nshutifidele23-cmd/BE-Ruche-avec-STM32-G15/BE RUCHE/LORA/Trammes/Signal Lora.jpeg

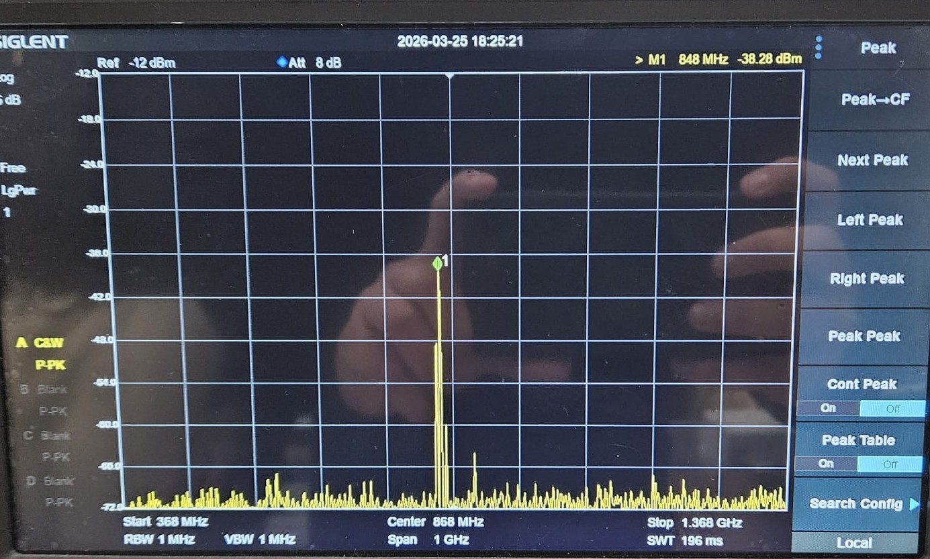
BE RUCHE/LORA/Trammes/Signal Lora.jpeg
