nshutifidele23-cmd/BE-Ruche-avec-STM32-G15/TP CAPTEURS/Compte_Rendu_TP_Partie_Capteur_STM32_2026_G15.pdf

Département EEA - Faculté Sciences et Ingénierie

## M1 EEA Parcours Systemes et Microsystemes Embarques

## Compte Rendu du BE partie capteurs

Année 2025–2026

Rédigé par ARIEF Audy et NSHUTI NKURIKIYINKA Fidèle

4 avril 2026

Université de Toulouse | Master Systèmes et Microsystèmes Embarqués

Table des matières

1 Introduction | 2
2 Capteur SHT31 | 2
3 Capteur DHT11 | 2
4 Affichage LCD : lcd_affichage | 4
5 Conclusion | 4

### 1 Introduction

Ce TP constitue la première étape du projet de ruche connectée. L’objectif de cette partie est de prendre en main deux capteurs de température et d’humidité (SHT31 et le DHT11) sur la carte STM32L476RG (Nucleo-L476RG), de comprendre leurs protocoles de communication respectifs, et d’afficher les mesures sur un écran LCD RGB I2C.
Les deux capteurs mesurent les mêmes grandeurs physiques (température et humidité relative) mais avec des interfaces très différentes : le SHT31 communique via le bus I2C, tandis que le DHT11 utilise un protocole propriétaire mono fil à base de durées d’impulsions. Ce TP permet de comparer deux approches d’interfaçage courantes.

### 2 Capteur SHT31

### 2.1 Présentation du capteur

Le SHT31 est un capteur numérique de température et d’humidité relative fabriqué par Sensirion. Il offre une précision de ± 0,3 °C en température et ± 2 % en humidité relative. La communication s’effectue via le bus I2C, avec une adresse configurable par la broche ADDR (0x44 ou 0x45).

### 2.2 Protocole de communication I2C

Le SHT31 fonctionne par envoi de commandes sur 2 octets. L’hôte envoie une commande de mesure, attend la fin de la conversion, puis lit 6 octets en retour : 2 octets de température, 1 octet de CRC, 2 octets d’humidité, 1 octet de CRC.

### 2.3 Implémentation : sht_init

Notre implémentation se concentre sur la fonction d’initialisation sht_init, qui envoie la commande de déclenchement d’une mesure en mode répétabilité haute (0x2C, 0x10) via HAL_I2C_Master_Transmit sur l’adresse SHT_ADDRESS_A. Un délai de 5 ms est ensuite respecté pour laisser le temps au capteur de compléter la conversion avant toute lecture. Cette commande est appelée en boucle dans le main, avec un délai de 1 s entre chaque déclenchement.

### 2.4 Résultat

À ce stade du TP, l’initialisation et le déclenchement de mesure ont été validés. La commande est transmise correctement sur le bus I2C et le capteur répond sans erreur. La lecture et le décodage des 6 octets de réponse constituent la prochaine étape d’intégration.

### 3 Capteur DHT11

### 3.1 Présentation du capteur

Le DHT11 est un capteur bas coût de température et d’humidité relative. Sa précision est limitée (± 2 °C, ± 5 % HR) mais il est largement utilisé pour des applications de prototypage. Il communique via un protocole propriétaire mono-fil : une seule broche GPIO assure à la fois l’envoi de la commande de déclenchement et la réception des données, en codant les bits par la durée des états haut et bas.

### 3.2 Gestion du temps en microsecondes

Le protocole DHT11 requiert des délais précis à l’échelle de la microseconde, que HAL_Delay ne peut pas fournir (résolution 1 ms). Nous avons donc implémenté une fonction delay basée sur le timer TIM1, configuré avec un prescaler de 79 pour obtenir un comptage à 1 µs sur une horloge système de 80 MHz. La fonction réinitialise le compteur puis attend activement qu’il atteigne la valeur cible.

### 3.3 Initialisation : DHT11_Init

La séquence d’initialisation, conforme à la datasheet du DHT11, se déroule comme suit :

1. La broche GPIO est configurée en sortie et tirée à l’état bas pendant au moins 18 ms pour déclencher le capteur.
2. Elle est remontée à l’état haut pendant 10 µs, puis repassée en entrée avec résistance de tirage interne.
3. Après 40 µs d’attente, la fonction vérifie la réponse du DHT11 : celui-ci doit tirer la ligne à bas pendant ∼80 µs, puis la remettre à haut pendant ∼80 µs pour confirmer sa présence.
4. Un timeout de 2 ms (basé sur HAL_GetTick) est utilisé pour éviter un blocage infini si le capteur ne répond pas.

La fonction retourne 1 si le capteur a correctement répondu, 0 sinon.

### 3.4 Lecture des données : DHT11_Read

La fonction DHT11_Read lit un octet (8 bits) depuis le DHT11. Pour chaque bit, la logique est la suivante : le DHT11 signale le début d’un bit par une impulsion basse de ∼50 µs, puis encode le bit par la durée de l’état haut (∼26 µs pour un 0, ∼70 µs pour un 1). La fonction attend la fin de l’impulsion basse, puis échantillonne l’état de la ligne après 40 µs : si la ligne est encore haute, le bit vaut 1 ; si elle est déjà retombée, le bit vaut
0. Les bits sont accumulés du poids fort au poids faible dans un octet retourné en fin de fonction.
Cette fonction est appelée 5 fois consécutivement dans le main : 2 octets d’humidité (MSB, LSB), 2 octets de température (MSB, LSB), et 1 octet de checksum.

### 3.5 Vérification et décodage dans le main

Après les 5 lectures, le main calcule la somme des 4 premiers octets et la compare au checksum reçu. Si la vérification réussit, les valeurs sont décodées :
— Température : si le MSB de TC1 est à 1 (bit 7), la température est négative et
calculée depuis TC2 ; sinon, les deux octets sont combinés par (TC1 « 8) | TC2
et divisés par 10 pour obtenir la valeur en °C. Le résultat est multiplié par 100 pour stocker deux décimales dans un entier.
— Humidité : même principe, combinaison de RH1 et RH2, divisée par 10, multipliée par 100.

### 4 Affichage LCD : lcd_affichage

La fonction lcd_affichage efface l’écran et affiche sur deux lignes :
— Ligne 0 : Temp : XX.XX °C (le symbole degré est produit par le code caractère 0xDF du LCD) ;
— Ligne 1 : Humi : XX.XX %.
Le formatage utilise la même technique que pour le poids dans le BE Ruche : la division entière par 100 donne la partie entière, le modulo 100 donne les deux chiffres décimaux, évitant ainsi l’utilisation des flottants dans sprintf. Le rétroéclairage est maintenu en blanc.

### 5 Conclusion

Ce TP a permis de comparer deux approches très différentes d’interfaçage de capteurs environnementaux sur STM32. Le SHT31, piloté via I2C avec les fonctions HAL standard, s’est révélé simple à intégrer et offre une bonne précision. Le DHT11, avec son protocole mono fil et ses contraintes temporelles à la microseconde, a nécessité une implémentation plus manuelle, notamment pour la gestion du timer et le décodage bit à bit.
