nshutifidele23-cmd/BE-Ruche-avec-STM32-G15/BE RUCHE/LCD_HX711_STM32/Trammes/trame_Communication_HX711.PNG

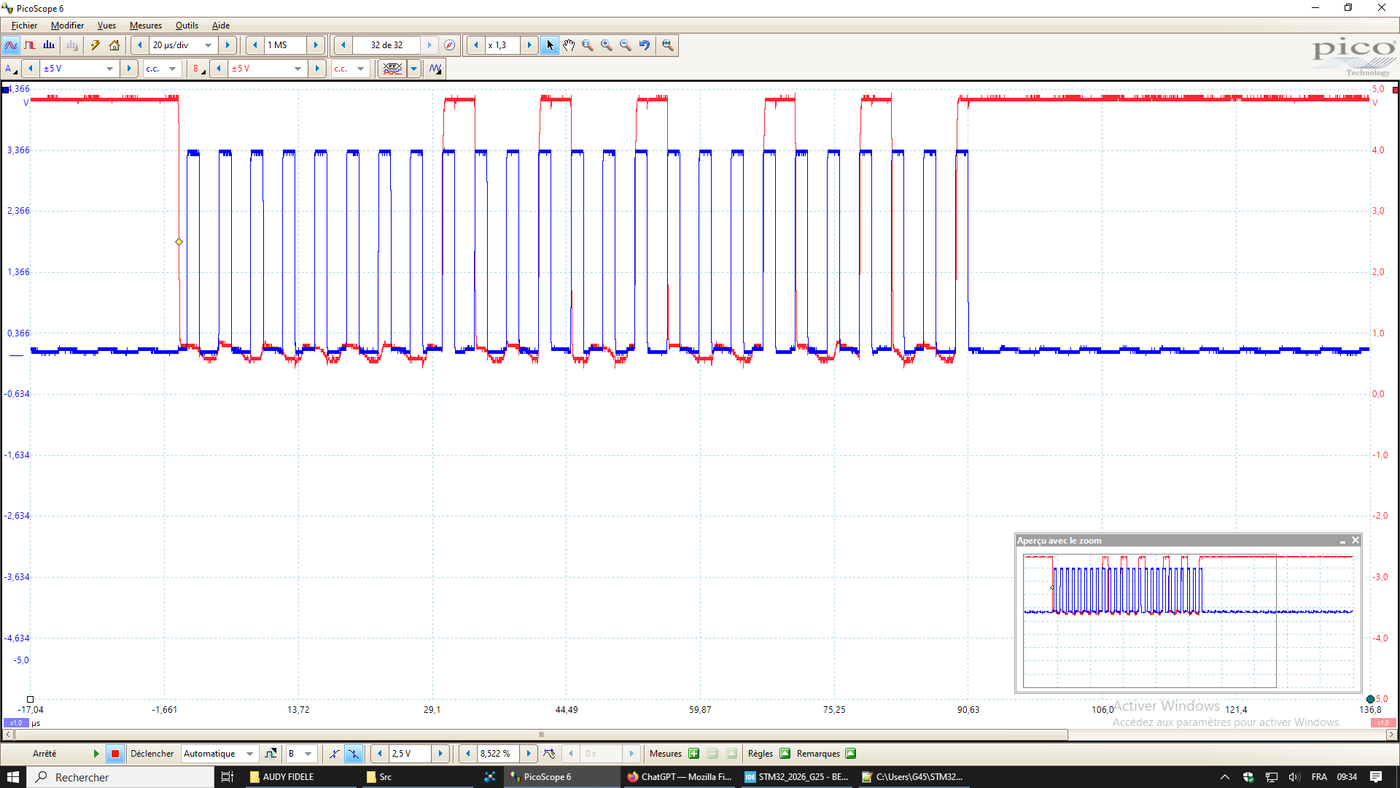
BE RUCHE/LCD_HX711_STM32/Trammes/trame_Communication_HX711.PNG
