nshutifidele23-cmd/BE-Ruche-avec-STM32-G15/BE RUCHE/LCD_HX711_STM32/Trammes/Tramme_Message_1s_HX711.PNG

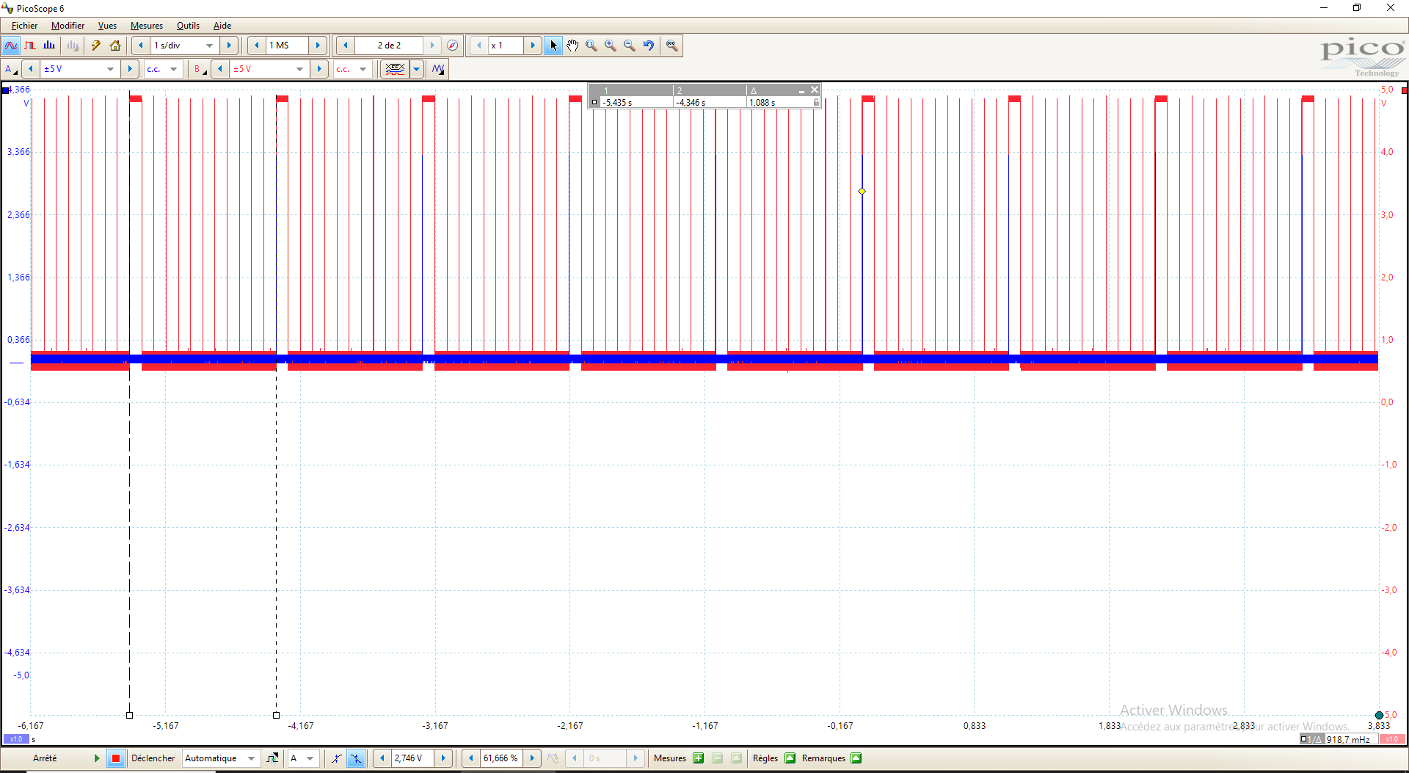
BE RUCHE/LCD_HX711_STM32/Trammes/Tramme_Message_1s_HX711.PNG
