nshutifidele23-cmd/BE-Ruche-avec-STM32-G15/TP CAPTEURS/DHT11/Docs/dht11 tramme.PNG

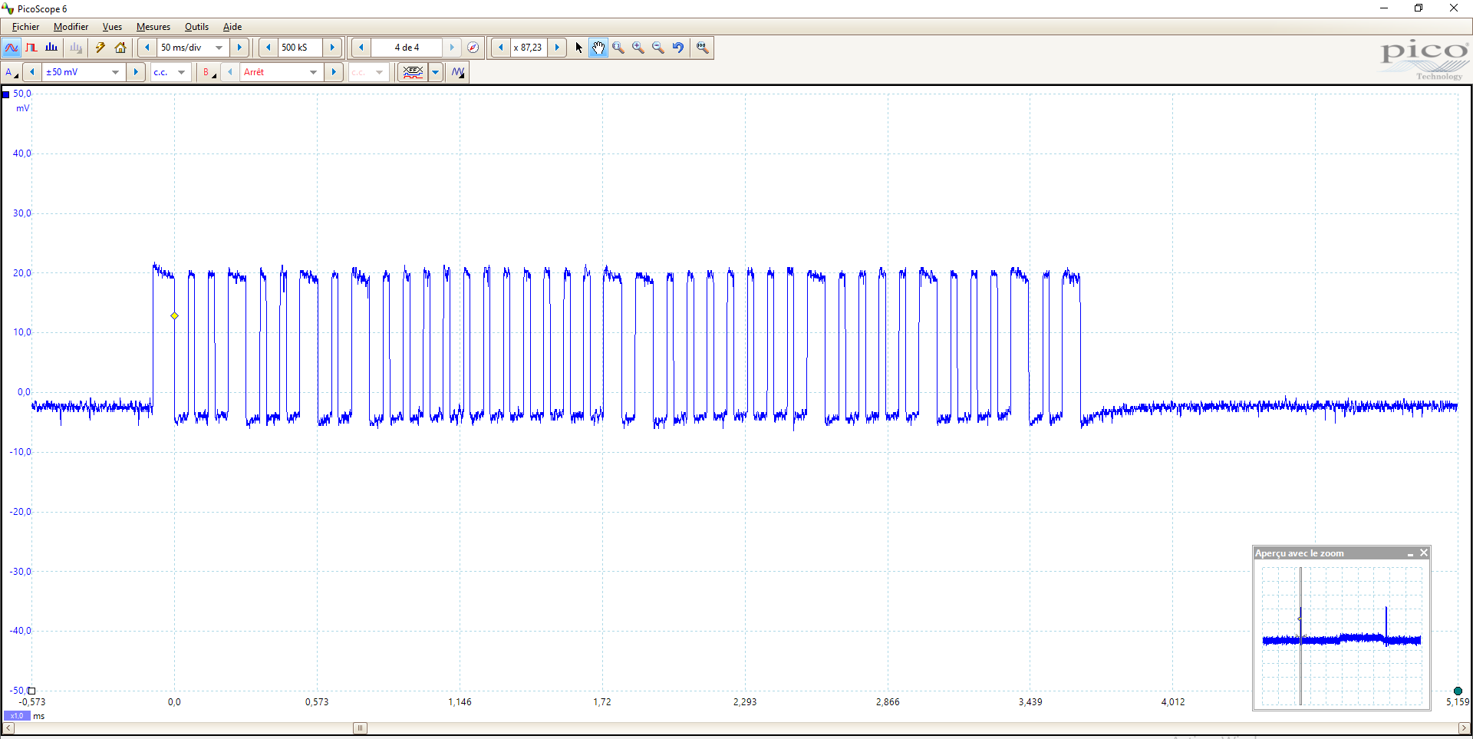
TP CAPTEURS/DHT11/Docs/dht11 tramme.PNG
