nshutifidele23-cmd/BE-Ruche-avec-STM32-G15/TP CAPTEURS/SHT31/Docs/Tramme SHT31 Init.PNG

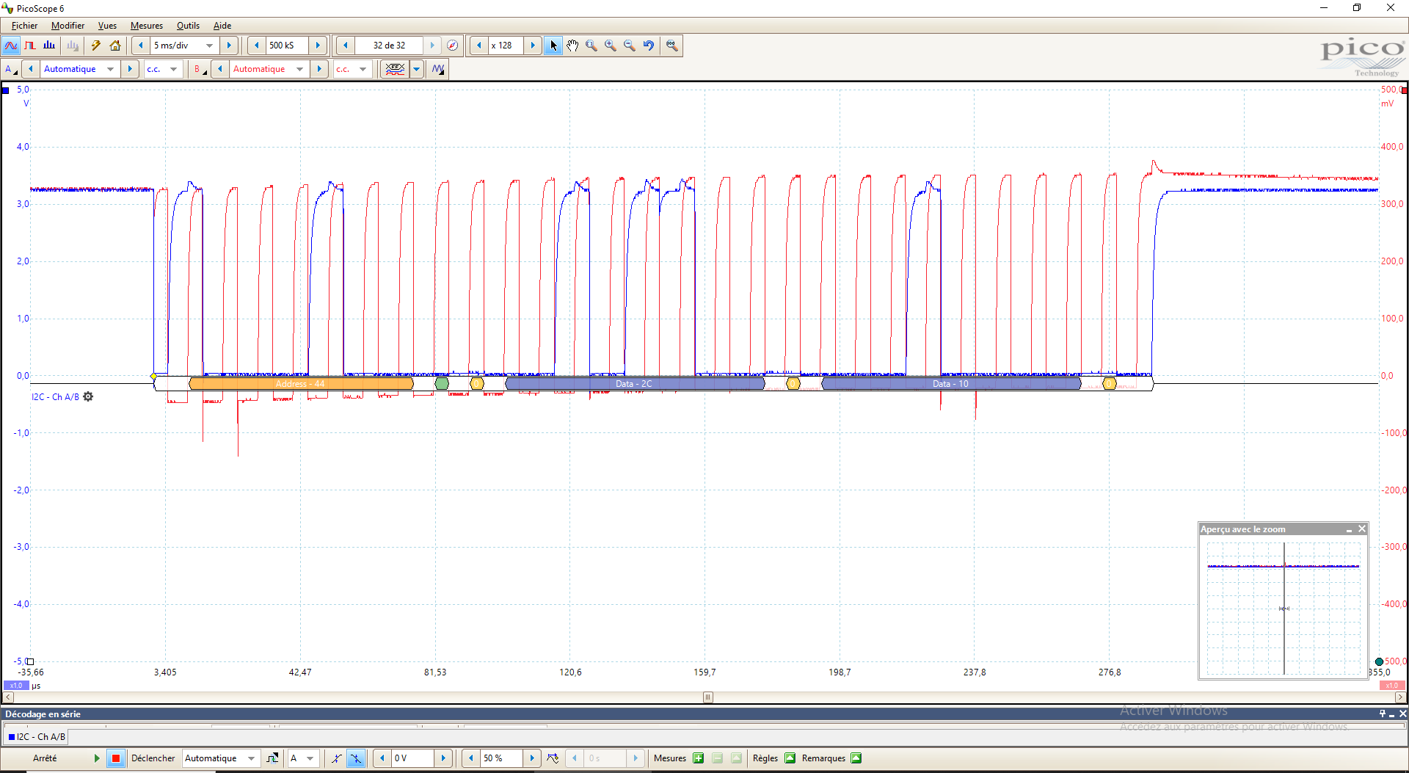
TP CAPTEURS/SHT31/Docs/Tramme SHT31 Init.PNG
