nshutifidele23-cmd/BE-Ruche-avec-STM32-G15/BE RUCHE/Schema de cablage/Schematic_BE_Ruche_2026-04-01.pdf

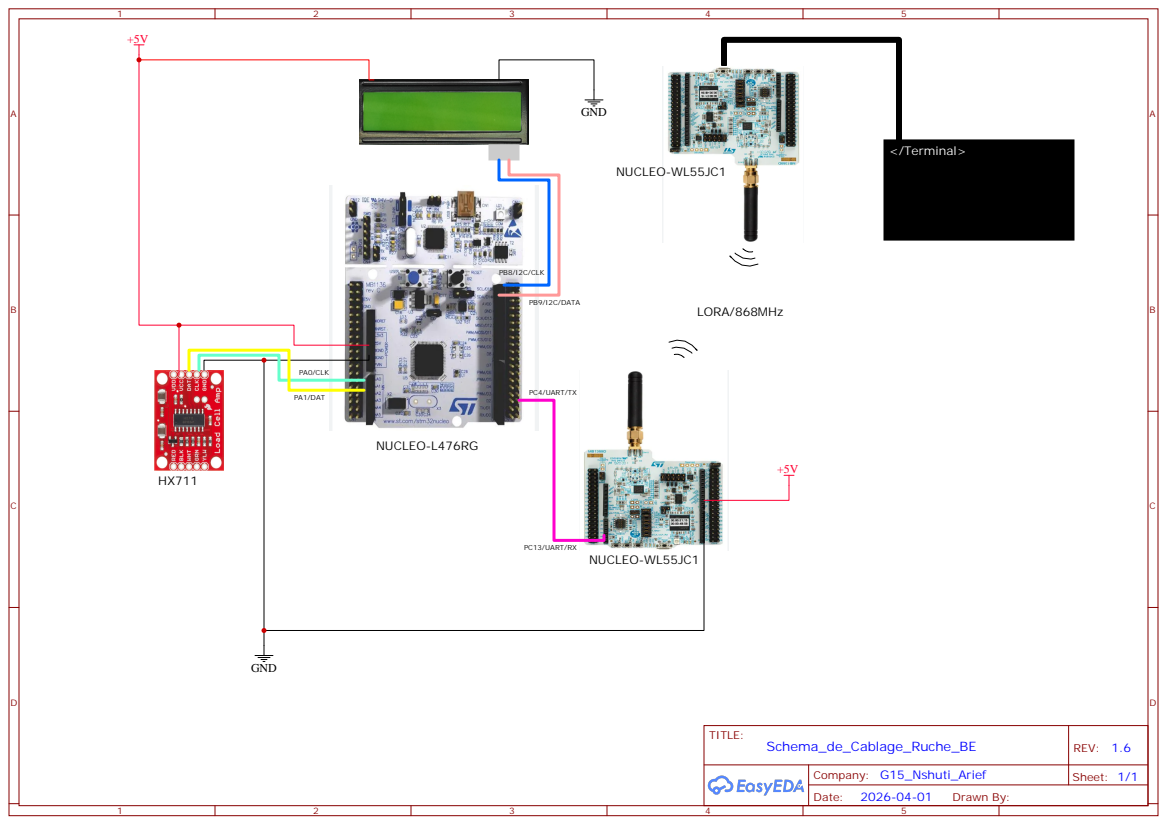
[picture p7: page 1]
