nshutifidele23-cmd/BE-Ruche-avec-STM32-G15/TP CAPTEURS/LED/Core/Inc/main.h

#define B1_Pin GPIO_PIN_13
#define B1_GPIO_Port GPIOC
#define B1_EXTI_IRQn EXTI15_10_IRQn
#define USART_TX_Pin GPIO_PIN_2
#define USART_TX_GPIO_Port GPIOA
#define USART_RX_Pin GPIO_PIN_3
#define USART_RX_GPIO_Port GPIOA
#define LD2_Pin GPIO_PIN_5
#define LD2_GPIO_Port GPIOA
#define uikjiki_Pin GPIO_PIN_8
#define uikjiki_GPIO_Port GPIOA
#define uikjiki_EXTI_IRQn EXTI9_5_IRQn
#define GPIO_PIN__Pin GPIO_PIN_9
#define GPIO_PIN__GPIO_Port GPIOA
#define GPIO_PIN__EXTI_IRQn EXTI9_5_IRQn
#define TMS_Pin GPIO_PIN_13
#define TMS_GPIO_Port GPIOA
#define TCK_Pin GPIO_PIN_14
#define TCK_GPIO_Port GPIOA
#define SWO_Pin GPIO_PIN_3
#define SWO_GPIO_Port GPIOB
