nshutifidele23-cmd/BE-Ruche-avec-STM32-G15/TP CAPTEURS/DHT11/Core/Src/main.c

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
/* Includes ------------------------------------------------------------------*/
#include "main.h"
#include "i2c.h"
#include "tim.h"
#include "usart.h"
#include "gpio.h"
#include "string.h"
#include "stdio.h"

/* USER CODE BEGIN Includes */
#include "dht.h"
#include "lcd.h"


/* USER CODE END Includes */


/* USER CODE BEGIN PV */
// Buffer d'affichage LCD (16 caractères max par ligne)
char lcd_buf[16];

// Variables globales pour la température et l'humidité
// Valeurs multipliées par 100 
int temp,hum;

/* USER CODE END PV */

void SystemClock_Config(void);
/* USER CODE BEGIN PFP */


/*
 * Fonction : lcd_affichage
 *
 * Rôle :
 * - Efface l'écran LCD
 * - Affiche la température sur la première ligne au format XX.XX °C
 * - Affiche l'humidité sur la deuxième ligne au format XX.XX %
 *
 * - La température est fournie sous forme entière multipliée par 100
 * - L'humidité est également fournie multipliée par 100
 * - L'affichage se fait via le bus I2C (hi2c1)
 */

void lcd_affichage(int T, int H){

	clearlcd();
	sprintf(lcd_buf,"Temp: %d.%d%cC",(temp/100),(temp%100),0xDF);
	lcd_position(&hi2c1,0,0);
	lcd_print(&hi2c1,lcd_buf);

	sprintf(lcd_buf,"Humi: %d.%d%%",(H/100),(H%100));
	lcd_position(&hi2c1,0,1);
	lcd_print(&hi2c1,lcd_buf);
	//lcd_print(&hi2c1,"test");

	reglagecouleur(255,255,255);
}


/* USER CODE END PFP */

/**
  * @brief  The application entry point.
  * @retval int
  */
int main(void)
{

  /* USER CODE BEGIN 1 */
	uint8_t RH1, RH2, TC1, TC2 , SUM, Check,tCelsius,RH_fin;
  /* USER CODE END 1 */

  /* MCU Configuration--------------------------------------------------------*/

  /* Reset of all peripherals, Initializes the Flash interface and the Systick. */
  HAL_Init();

  /* USER CODE BEGIN Init */
  rgb_lcd lcdData;

  /* USER CODE END Init */

  /* Configure the system clock */
  SystemClock_Config();

  /* Initializations de peripheriques */
  MX_GPIO_Init();
  MX_USART2_UART_Init();
  MX_TIM1_Init();
  MX_I2C1_Init();

  // Initialisation de l'ecran LCD
  lcd_init(&hi2c1,&lcdData);
  /* Infinite loop */
  /* USER CODE BEGIN WHILE */
  while (1)
  {
    /* USER CODE END WHILE */

    /* USER CODE BEGIN 3 */

    //Initialisation et handshake avec le DHT11
	  if(DHT11_Init())

	  {

		  // MSB LSB Humidite
		  RH1 = DHT11_Read();
		  RH2 = DHT11_Read();

		  // MSB LSB Temp
		  TC1 = DHT11_Read();
		  TC2 = DHT11_Read();

		  //check sum
		  SUM = DHT11_Read();

		  Check = RH1 + RH2 + TC1 + TC2;

		  //pas d'erreur checksum
		  if (Check == SUM)
		  {

			  if (TC1>127) // en dessous de 0

			  {

				  tCelsius = (float)TC2/10*(-1);
				  temp = tCelsius *100;

			  }

			  else

			  {

				  tCelsius = (float)((TC1<<8)|TC2)/10;
				  temp = tCelsius *100;


			  }



			  RH_fin = (float) ((RH1<<8)|RH2)/10;
			  hum = RH_fin *100;



		  }

	  	  	  }

     // Affichage des valeurs sur l'écran LCD
	  lcd_affichage(temp, hum);

	  //Display_Temp(tCelsius);

	  //Display_Rh(RH);

	  HAL_Delay(1000);
  }
  /* USER CODE END 3 */
}

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
