nshutifidele23-cmd/BE-Ruche-avec-STM32-G15/BE RUCHE/LCD_HX711_STM32/Inc/be.h

#ifndef HX711_H_
#define HX711_H_

#include "stm32l4xx_hal.h"
#include <stdint.h>



typedef struct
{
  GPIO_TypeDef  *clk_gpio;
  GPIO_TypeDef  *dat_gpio;
  uint16_t      clk_pin;
  uint16_t      dat_pin;
  int32_t       offset;
  float         coef;
  uint8_t       lock;

}hx711_t;



void        hx711_init(hx711_t *hx711, GPIO_TypeDef *clk_gpio, uint16_t clk_pin, GPIO_TypeDef *dat_gpio, uint16_t dat_pin);
int32_t     hx711_value(hx711_t *hx711);
int32_t     hx711_value_ave(hx711_t *hx711, uint16_t sample);

void        hx711_coef_set(hx711_t *hx711, float coef);
float       hx711_coef_get(hx711_t *hx711);
void        hx711_calibration(hx711_t *hx711, int32_t value_noload, int32_t value_load, float scale);
void        hx711_tare(hx711_t *hx711, uint16_t sample);
float       hx711_weight(hx711_t *hx711, uint16_t sample);
void        hx711_power_down(hx711_t *hx711);
void        hx711_power_up(hx711_t *hx711);
void hx711_delay_us();



#ifdef __cplusplus
}
#endif

#endif
