nshutifidele23-cmd/BE-Ruche-avec-STM32-G15/BE RUCHE/Gateway/gate_way_script.py

import serial
import requests

ser = serial.Serial("COM3", 115200)  # il faut changer le PORT manuelement

API_KEY = "09T0WCVX9FPUAWNN"

while True:
    line = ser.readline().decode().strip()
    weight = float(line)

    requests.get(
        "https://api.thingspeak.com/update",
        params={"api_key": API_KEY, "Poids": weight}
    )
