nshutifidele23-cmd/BE-Ruche-avec-STM32-G15/(notices)

Notices in the files:
TP CAPTEURS/DHT11/Core/Src/main.c:
Copyright (c) 2026 STMicroelectronics.
All rights reserved.
This software is licensed under terms that can be found in the LICENSE file
